Youba0/Alimentation-photvoltaique-portable-/README.md

portable photovoltaic power supply
